lnls-sirius/vacuum-bbb-controller/README.md

# vacuum-bbb-controller
Graphical interface [./software/pydm/pydm_1.2/README.md](./software/pydm/pydm_1.2/README.md)
