lnls-sirius/vacuum-bbb-controller/documentation/readme/pcb_bottom_layer.png

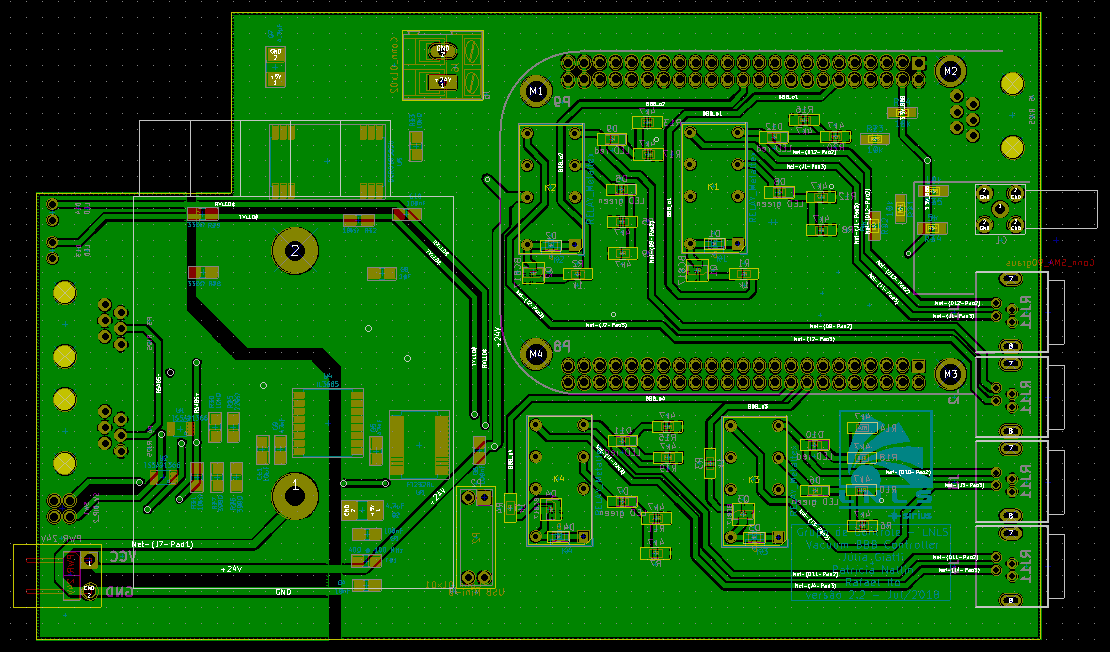
documentation/readme/pcb_bottom_layer.png
