lnls-sirius/vacuum-bbb-controller/documentation/readme/pcb_top_layer.png

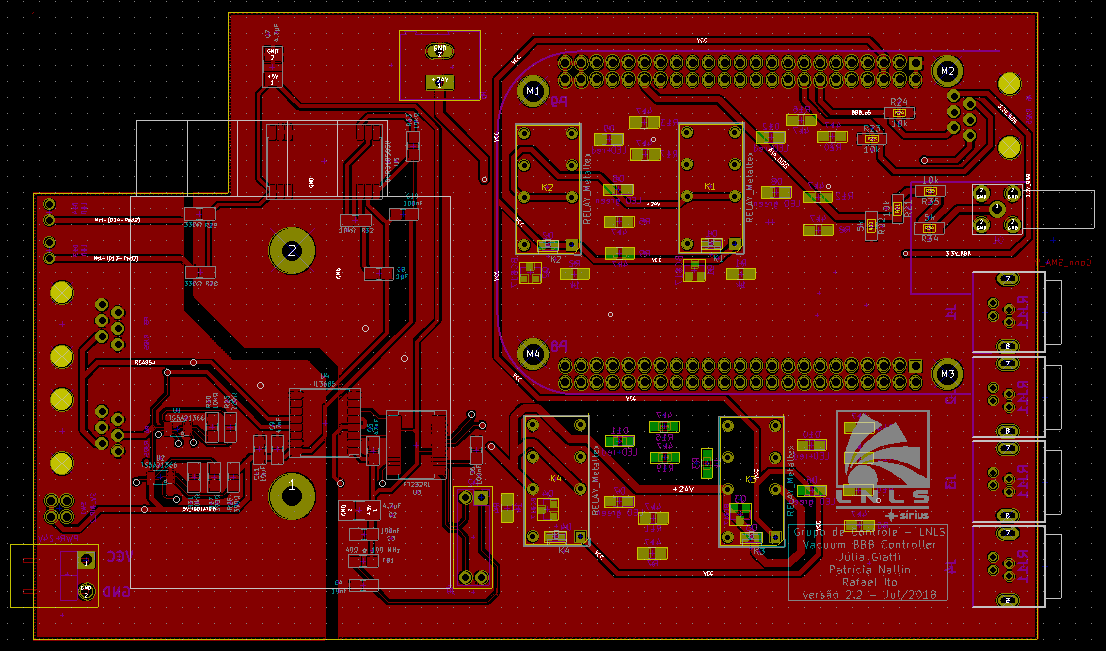
documentation/readme/pcb_top_layer.png
