lnls-sirius/vacuum-bbb-controller/documentation/readme/ui_1_main-window.png

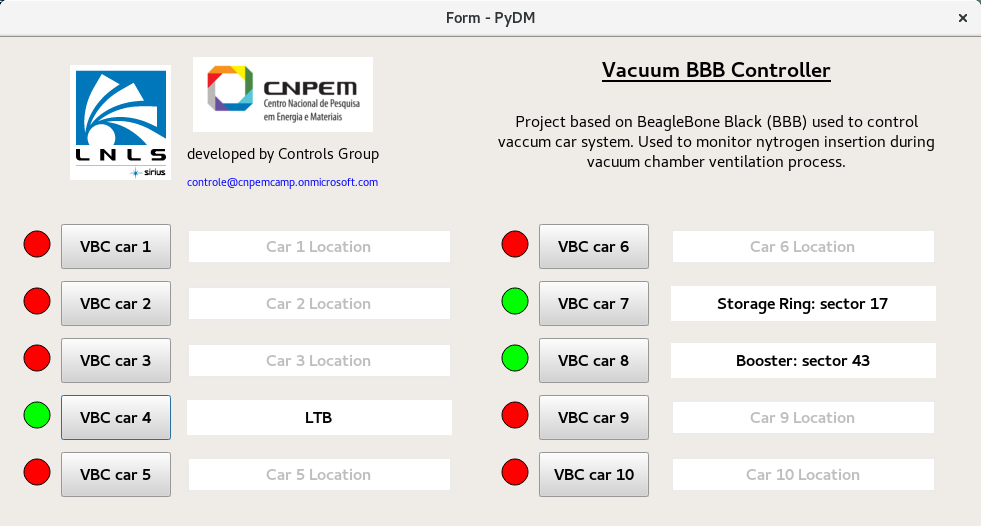
documentation/readme/ui_1_main-window.png
