lnls-sirius/vacuum-bbb-controller/documentation/readme/ui_2_system_window.png

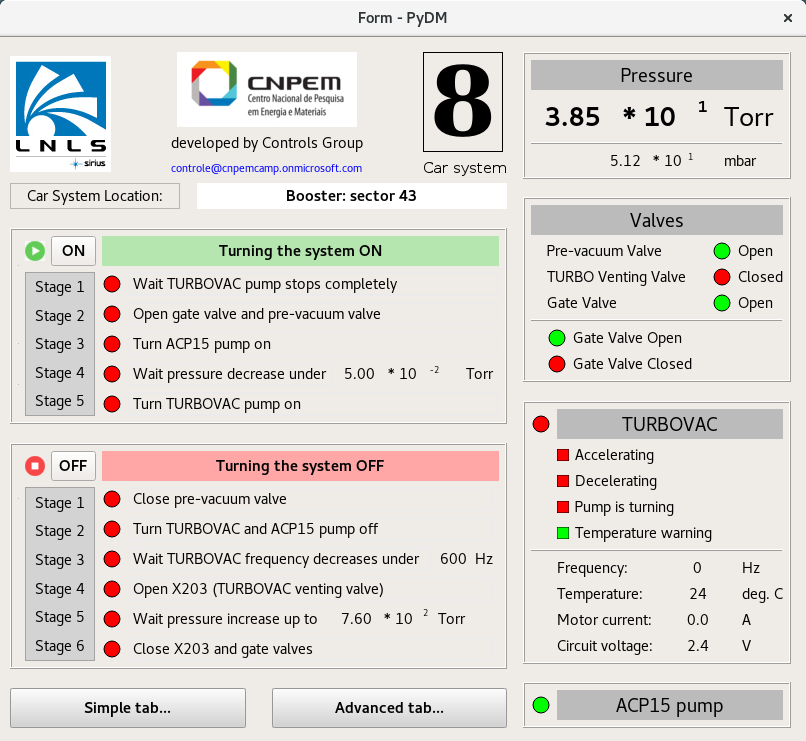
documentation/readme/ui_2_system_window.png
