lnls-sirius/vacuum-bbb-controller/documentation/readme/ui_3_simple_tab.png

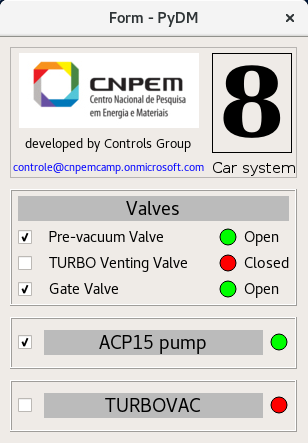
documentation/readme/ui_3_simple_tab.png
