lnls-sirius/vacuum-bbb-controller/documentation/readme/ui_4_advanced_tab_1.png

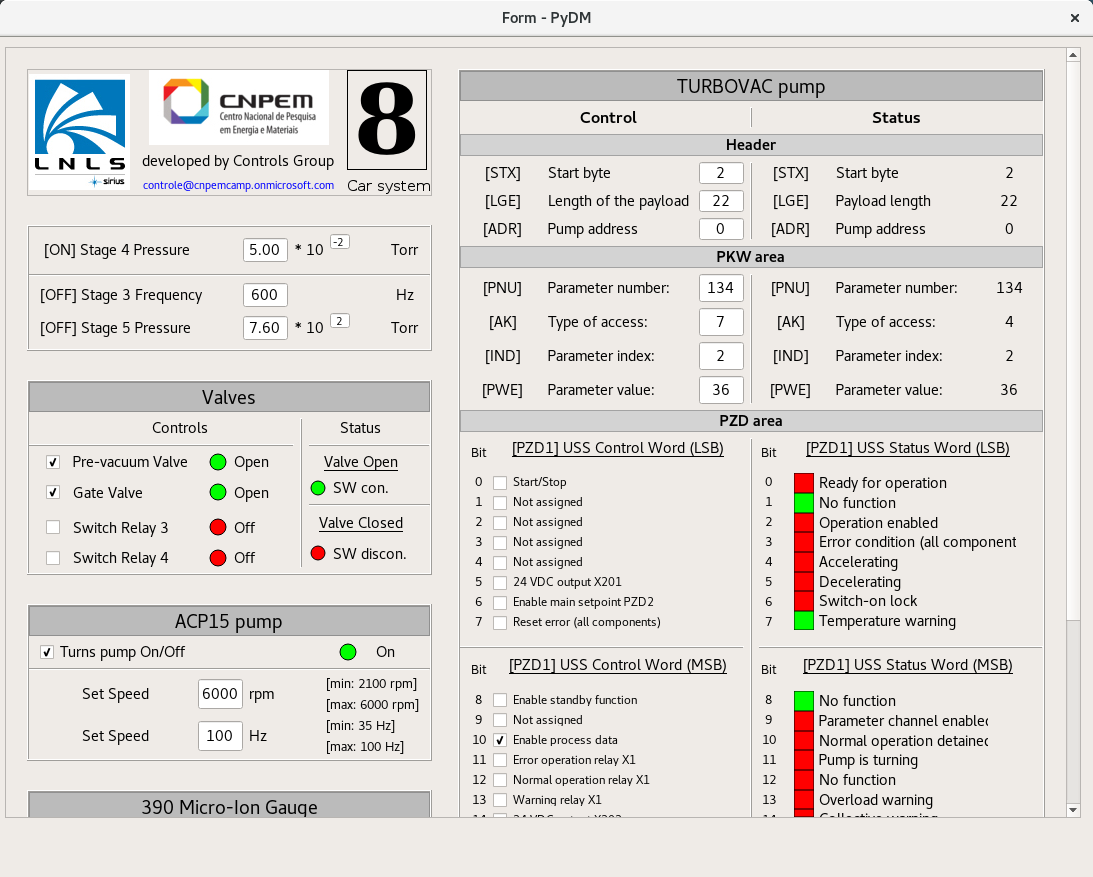
documentation/readme/ui_4_advanced_tab_1.png
