lnls-sirius/vacuum-bbb-controller/documentation/readme/ui_5_advanced_tab_2.png

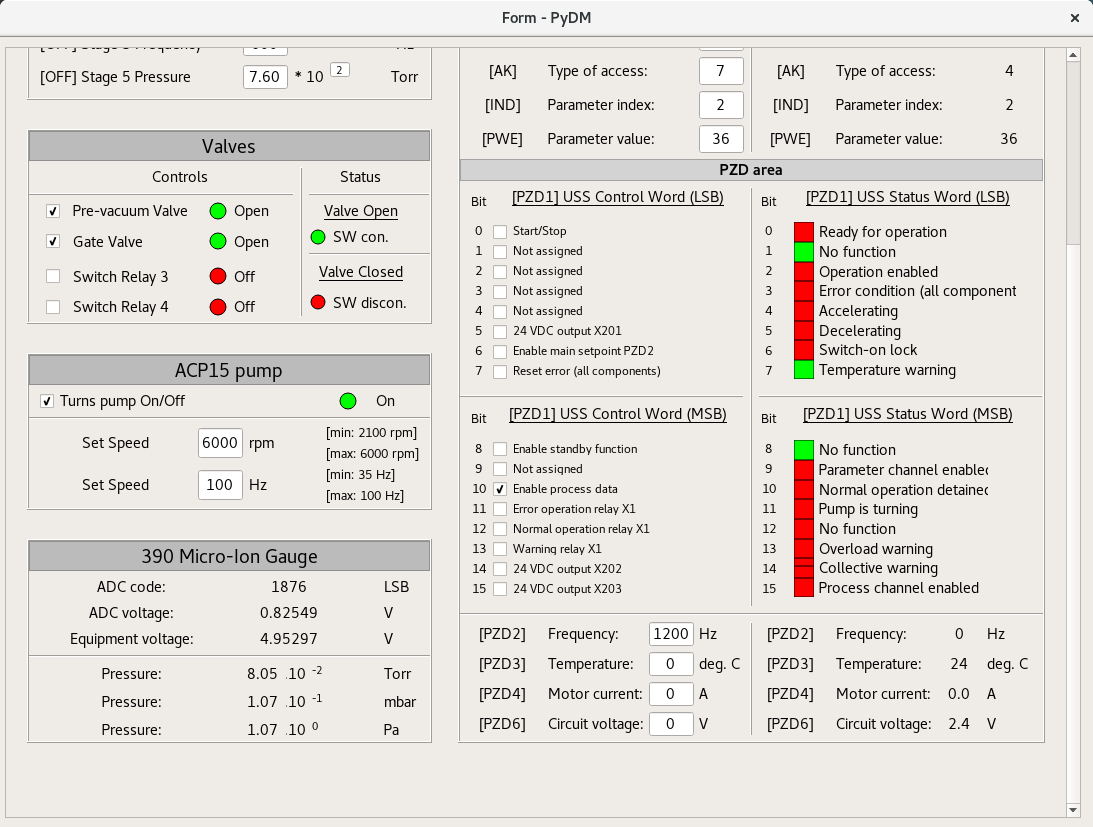
documentation/readme/ui_5_advanced_tab_2.png
