lnls-sirius/vacuum-bbb-controller/hardware/cables/cables.ods

Sheet: Contador
Designator | Description | Value | PartNumber | Package | Manufacturer | Quantity | CNPEM Part Number | OBS | Packaging
Beagle1 | 2x Pin Heander para a BeagleBone Black | BeagleBone | ZW-23-12-F-D-754-178 | 2x Straight_2x23 pitch 2.54mm | SAMTEC | 2 | MT104047 |  | Unit
BR1,BR2 | Bridge Rectifier Single Phase Standard 100V SMD | Diode_Bridge | DF01S-T | RECT_BRIDGE | Diodes Incorporated | 2 | MT107907 |  | Tape
C1 | Aluminum Electrolytic Capacitors Radial SMD 470µF 16V | 470uF | EEE-1CA471UP | CP_Elec_8x5.4 | Panasonic Electronic Components | 1 | AP106777 |  | Tape
C2 | Multilayer Ceramic Capacitors 4.7µF 50V ±10% X7R 1210 SMD | 4.7uF | GRM21BR61E475MA12L | 1210 | Murata | 1 | MT104428 |  | Reel
C27 | Tantalum Capacitor 100uF, 10V, 20%, ESR 0.9ohm | 100uF | TLJT107M010R0900 | 1210 | AVX | 1 | MT103959 |  | Tape
C3,C4 | Ceramic Capacitor SMD ±5% 16V X7R | 1uF | C0805C105J4RACTU | 0805 | AVX | 2 | MT109488 |  | Reel
C30 | Tantalum Capacitor 10uF, 10V, 10%, ESR 3.8ohm | 10uF | 08053C105JAT2A | 1206 | Kemet | 1 | AP111595 |  | Tape
C6 | Ceramic Capacitor 10uF 16V 10% SMD 0805 X5R | 10uF | CL21A106KOQNNNE | 0805 | Samsung ElectroMechanics | 1 | MT104058 |  | Reel
C7,C28,C29 | Multilayer Ceramic Capacitor 100nF 50V 5% SMD 0805 X7R | 100nF | GCM21BR72A104KA37L | 0805 | Murata | 3 | MT114854 |  | Reel
C8,C5,C9,C10 | Ceramic Capacitor 33pF 50V 10% SMD 0805 C0G/NP0 | 33pF | 08055A330JAT2A | 0805 | AVX | 4 | MT112460 |  | Reel
D1 | LED Circuit Board Indicator Single Red Diffused, Through Hole, Right Angle 2V 20mA 90° | LED-Red | WP934CB/ID | 2x1 PTH pitch 2,54mm | Kingbright | 1 | AP110389 |  | Unit
D9,D11 | Diode Schottky 40V 750mA (DC) Surface Mount | Schottky | BAT165E6327HTSA1 | SOD-323 | Infineon Technologies | 2 | MT104048 |  | Tape
D10,D12 | Red LED, 2V, 20mA, SMD 0805 | LED Red | LTST-C171KRKT | 0805 | Lite-On Inc | 2 | AP111653 |  | Reel
J1,J2,J3,J4 | RJ45 Jack Connector Right Angle | RJ45 | SS-60000-010 | RJ45-STEWART | Stewart | 4 | MT107916 |  | Tube
JP1 | DIP Switch SMD 1 position | Dip Switch 1 pos | KAE01SGGT | DIP Switch SMD 1 position | E-Switch | 1 | MT104049 |  | Tube
P1,P2 | Connector 90° PTH 02x08 | CONN_02X08 | 3221-16-0200-00 | 2x08_PTH_Pitch1.27mm | CNC Tech | 2 | MT107378 |  | Unit
Q3,Q2,Q1 | Bipolar (BJT) Transistor NPN SMD 40V 800mA 300MHz 350mW | BSR14 | BSR14 | SOT-23 | Fairchild Semiconductor | 3 | MT104051 |  | Tape
R11,R12 | Resistor SMD 100Ω ±1% 1W Thin Film | 100 | MMB02070C1000FB200 | MELF 0207 | Vishay | 2 | MT112459 |  | Reel
R13,R14 | Resistor SMD 120 Ω ±1% 0.125W Thick Film | 120 | 0805W8F1200T5E | 0805 | RoyalOhm | 2 | MT115760 |  | Reel
R16 | Resistor SMD 620Ω ±1% 0.125W Thick Film | 620 | RK73H2ATTD6200F | 0805 | KOA Speer | 1 | MT109494 |  | Reel
R17 | Resistor SMD 180 ohm 1% 1/8W Thin Film | 180 | 0805W8F1800T5E | 0805 | RoyalOhm | 1 | MT114496 |  | Reel
R18,R5,R6 | Resistor SMD 1K ohm 1% 1/8W Thick Film | 1k | 0805W8F1001T5E | 0805 | RoyalOhm | 3 | MT109492 |  | Reel
R19,R20,R21,R22,R27,R30,R31 | Resistor SMD 10 kΩ ±1% 0.125W Thick Film | 10k | 0805W8F1002T5E | 0805 | RoyalOhm | 7 | MT109485 |  | Reel
R23,R2,R1,R24 | Resistor SMD 0 Ohms 0.125W Thick Film | 0 | RC0805JR-070RL | 0805 | Yageo | 4 | MT100803 | NÃO DEVEM SER MONTADOS | NÃO SERÁ FORNECIDO
R25 | Resistor 910K ohm 1% 1/8W SMD 0805 Thick Film | 910KΩ | 0805W8F9103T5E | 0805 | RoyalOhm | 1 | MT115761 |  | Reel
R26,R29 | Resistor 330 ohm, 1/8W, SMD 0805, Thick Film | 330Ω | 0805W8F3300T5E | 0805 | RoyalOhm | 2 | MT115762 |  | Reel
R28 | Resistor 220K ohm 1% 1/8W SMD 0805 Thick Film | 220kΩ | 0805W8F2203T5E | 0805 | RoyalOhm | 1 | MT115763 |  | Reel
R3,R4 | Resistor SMD 100Ω ±1% 0.125W Thick Film | 100 | RK73H2ATTD1000F | 0805 | KOA Speer | 2 | MT115765 |  | Reel
R7,R8,R9,R10, R15 | Resistor SMD 4.7 kΩ ±1% 0.125W Thick Film | 4k7 | 0805W8F4701T5E | 0805 | RoyalOhm | 4 | MT115764 |  | Reel
T1 | Module XFRMR LAN 10/100 PoE SMD | Module-XFRMR-POE | S558-5500-25-F | Module-XFRMR-Poe | Bel Fuse Inc. | 1 | MT107908 |  | Tape
T2,T3 | 2 Line Common Mode Choke Surface Mount 500 Ohm @ 100MHz 4A DCR 27 mOhm | Transformer_1P_1S | DLW5BTM501SQ2L | Horizontal, 6 PC Pad | Murata | 2 | MT109675 |  | Tape
U1,U2,U3,U4,U5,U6,U23,U24 | Single D-type Flip-flop | 741G74 | 296-25554-2-ND | TSSOP-8 | Texas Instruments | 8 | AP105702 |  | Tape
U14,U15,U20 | 2 Circuit IC Switch 1:1 1Ω US8 | TS5A21366 | TS5A21366DCUR | VSSOP-8 | Texas Instruments | 3 | AP109801 |  | Tape
U16 | Isolated PoE module Output 5V – 13W | Ag9200 | AG9205S | 9200-Silvertel | Silvertel | 1 | MT107905 |  | Unit
U17 | Isolated Module DC DC Converter 5V→5V 200mA 1W | VIBLSD1-S5-S5-DIP | VIBLSD1-S5-S5-DIP | 14-DIP-5 Leads | CUI Inc. | 1 | MT108027 |  | Tube
U18 | Isolated Module DC DC Converter 5V→±12V 42mA 1W | MEV1D0512DC | MEV1D0512DC | 14-DIP-6 Leads | Murata Power Solutions Inc. | 1 | MT108008 |  | Tube
U19,U22 | IC Single 2-input AND Gate SMD SOT-353 | 1G08 | 74AHC1G08SE-7 | SOT-353 | Diodes Inc | 2 | MT104245 |  | Reel
U21 | IC 74HC123 SMD SOIC-16 | 74HC123 | 74HC123D | SOIC-16 | NXP Semiconductors | 1 | AP111593 |  | Tape
U7,U12,U13 | Buffer Inverting 1 channel SMD | 1G04 | 74AHC1G04SE-7 | SOT-353 | Diodes Inc | 3 | MT104246 |  | Reel
U8,U9,U10,U11,U25,U26 | Buffer Non-Inverting Push-Pull Output | 1G125 | 74AHC1G125SE-7 | SOT-353 | Nexperia Inc | 6 | MT103958 |  | Reel

Sheet: Montagem mecânica
Designator | Description | Value | PartNumber | Package | Manufacturer | Quantity | CNPEM Part Number | OBS | Packaging
Beagle1 | 2x Pin Heander para a BeagleBone Black | BeagleBone | ZW-23-12-F-D-754-178 | 2x Straight_2x23 pitch 2.54mm | SAMTEC | 2 | MT104047 |  | Unit | 312
BR1,BR2 | Bridge Rectifier Single Phase Standard 100V SMD | Diode_Bridge | DF01S-T | RECT_BRIDGE | Diodes Incorporated | 2 | MT107907 |  | Tape | 392
C1 | Aluminum Electrolytic Capacitors Radial SMD 470µF 16V | 470uF | EEE-1CA471UP | CP_Elec_8x5.4 | Panasonic Electronic Components | 1 | AP106777 |  | Tape | 200
C2 | Multilayer Ceramic Capacitors 4.7µF 50V ±10% X7R 1210 SMD | 4.7uF | GRM21BR61E475MA12L | 1210 | Murata | 1 | MT104428 |  | Reel | 500
C27 | Tantalum Capacitor 100uF, 10V, 20%, ESR 0.9ohm | 100uF | TLJT107M010R0900 | 1210 | AVX | 1 | MT103959 |  | Tape | 250
C3,C4 | Ceramic Capacitor SMD ±5% 16V X7R | 1uF | C0805C105J4RACTU | 0805 | AVX | 2 | MT109488 |  | Reel | 1500
C30 | Tantalum Capacitor 10uF, 10V, 10%, ESR 3.8ohm | 10uF | 08053C105JAT2A | 1206 | Kemet | 1 | AP111595 |  | Tape | 250
C6 | Ceramic Capacitor 10uF 16V 10% SMD 0805 X5R | 10uF | CL21A106KOQNNNE | 0805 | Samsung ElectroMechanics | 1 | MT104058 |  | Reel | 423
C7,C28,C29 | Multilayer Ceramic Capacitor 100nF 50V 5% SMD 0805 X7R | 100nF | GCM21BR72A104KA37L | 0805 | Murata | 3 | MT114854 |  | Reel | 3000
C8,C5,C9,C10 | Ceramic Capacitor 33pF 50V 10% SMD 0805 C0G/NP0 | 33pF | 08055A330JAT2A | 0805 | AVX | 4 | MT112460 |  | Reel | 3500
D1 | LED Circuit Board Indicator Single Red Diffused, Through Hole, Right Angle 2V 20mA 90° | LED-Red | WP934CB/ID | 2x1 PTH pitch 2,54mm | Kingbright | 1 | AP110389 |  | Unit | 175
D9,D11 | Diode Schottky 40V 750mA (DC) Surface Mount | Schottky | BAT165E6327HTSA1 | SOD-323 | Infineon Technologies | 2 | MT104048 |  | Tape | 500
D10,D12 | Red LED, 2V, 20mA, SMD 0805 | LED Red | LTST-C171KRKT | 0805 | Lite-On Inc | 2 | AP111653 |  | Reel | 3000
J1,J2,J3,J4 | RJ45 Jack Connector Right Angle | RJ45 | SS-60000-010 | RJ45-STEWART | Stewart | 4 | MT107916 |  | Tube | 600
JP1 | DIP Switch SMD 1 position | Dip Switch 1 pos | KAE01SGGT | DIP Switch SMD 1 position | E-Switch | 1 | MT104049 |  | Tube | 175
P1,P2 | Connector 90° PTH 02x08 | CONN_02X08 | 3221-16-0200-00 | 2x08_PTH_Pitch1.27mm | CNC Tech | 2 | MT107378 |  | Unit | 300
Q3,Q2,Q1 | Bipolar (BJT) Transistor NPN SMD 40V 800mA 300MHz 350mW | BSR14 | BSR14 | SOT-23 | Fairchild Semiconductor | 3 | MT104051 |  | Tape | 550
R11,R12 | Resistor SMD 100Ω ±1% 1W Thin Film | 100 | MMB02070C1000FB200 | MELF 0207 | Vishay | 2 | MT112459 |  | Reel | 2000
R13,R14 | Resistor SMD 120 Ω ±1% 0.125W Thick Film | 120 | 0805W8F1200T5E | 0805 | RoyalOhm | 2 | MT115760 |  | Reel | 4800
R16 | Resistor SMD 620Ω ±1% 0.125W Thick Film | 620 | RK73H2ATTD6200F | 0805 | KOA Speer | 1 | MT109494 |  | Reel | 4504
R17 | Resistor SMD 180 ohm 1% 1/8W Thin Film | 180 | 0805W8F1800T5E | 0805 | RoyalOhm | 1 | MT114496 |  | Reel | 4500
R18,R5,R6 | Resistor SMD 1K ohm 1% 1/8W Thick Film | 1k | 0805W8F1001T5E | 0805 | RoyalOhm | 3 | MT109492 |  | Reel | 4073
R19,R20,R21,R22,R27,R30,R31 | Resistor SMD 10 kΩ ±1% 0.125W Thick Film | 10k | 0805W8F1002T5E | 0805 | RoyalOhm | 7 | MT109485 |  | Reel | 3500
R23,R2,R1,R24 | Resistor SMD 0 Ohms 0.125W Thick Film | 0 | RC0805JR-070RL | 0805 | Yageo | 4 | MT100803 | NÃO DEVEM SER MONTADOS | NÃO SERÁ FORNECIDO | NÃO SERÁ FORNECIDO
R25 | Resistor 910K ohm 1% 1/8W SMD 0805 Thick Film | 910KΩ | 0805W8F9103T5E | 0805 | RoyalOhm | 1 | MT115761 |  | Reel | 5000
R26,R29 | Resistor 330 ohm, 1/8W, SMD 0805, Thick Film | 330Ω | 0805W8F3300T5E | 0805 | RoyalOhm | 2 | MT115762 |  | Reel | 5000
R28 | Resistor 220K ohm 1% 1/8W SMD 0805 Thick Film | 220kΩ | 0805W8F2203T5E | 0805 | RoyalOhm | 1 | MT115763 |  | Reel | 5000
R3,R4 | Resistor SMD 100Ω ±1% 0.125W Thick Film | 100 | RK73H2ATTD1000F | 0805 | KOA Speer | 2 | MT115765 |  | Reel | 4000
R7,R8,R9,R10, R15 | Resistor SMD 4.7 kΩ ±1% 0.125W Thick Film | 4k7 | 0805W8F4701T5E | 0805 | RoyalOhm | 4 | MT115764 |  | Reel | 5000
T1 | Module XFRMR LAN 10/100 PoE SMD | Module-XFRMR-POE | S558-5500-25-F | Module-XFRMR-Poe | Bel Fuse Inc. | 1 | MT107908 |  | Tape | 195
T2,T3 | 2 Line Common Mode Choke Surface Mount 500 Ohm @ 100MHz 4A DCR 27 mOhm | Transformer_1P_1S | DLW5BTM501SQ2L | Horizontal, 6 PC Pad | Murata | 2 | MT109675 |  | Tape | 388
U1,U2,U3,U4,U5,U6,U23,U24 | Single D-type Flip-flop | 741G74 | 296-25554-2-ND | TSSOP-8 | Texas Instruments | 8 | AP105702 |  | Tape | 1500
U14,U15,U20 | 2 Circuit IC Switch 1:1 1Ω US8 | TS5A21366 | TS5A21366DCUR | VSSOP-8 | Texas Instruments | 3 | AP109801 |  | Tape | 568
U16 | Isolated PoE module Output 5V – 13W | Ag9200 | AG9205S | 9200-Silvertel | Silvertel | 1 | MT107905 |  | Unit | 152
U17 | Isolated Module DC DC Converter 5V→5V 200mA 1W | VIBLSD1-S5-S5-DIP | VIBLSD1-S5-S5-DIP | 14-DIP-5 Leads | CUI Inc. | 1 | MT108027 |  | Tube | 175
U18 | Isolated Module DC DC Converter 5V→±12V 42mA 1W | MEV1D0512DC | MEV1D0512DC | 14-DIP-6 Leads | Murata Power Solutions Inc. | 1 | MT108008 |  | Tube | 150
U19,U22 | IC Single 2-input AND Gate SMD SOT-353 | 1G08 | 74AHC1G08SE-7 | SOT-353 | Diodes Inc | 2 | MT104245 |  | Reel | 3000
U21 | IC 74HC123 SMD SOIC-16 | 74HC123 | 74HC123D | SOIC-16 | NXP Semiconductors | 1 | AP111593 |  | Tape | 200
U7,U12,U13 | Buffer Inverting 1 channel SMD | 1G04 | 74AHC1G04SE-7 | SOT-353 | Diodes Inc | 3 | MT104246 |  | Reel | 3000
U8,U9,U10,U11,U25,U26 | Buffer Non-Inverting Push-Pull Output | 1G125 | 74AHC1G125SE-7 | SOT-353 | Nexperia Inc | 6 | MT103958 |  | Reel | 3000
 | Cbo modular macho-macho 8P8C (RJ45,ETHERNET) |  | DK-1511-001/BL |  | Assmann WSW Components | 1 | MT107917 |  | Unit | 150
 | CAIXA DE ALUMINIO 159.99MM X 130.00MM X 53.00MM, TAMANHO EUROCARD |  | 1455N1601 |  |  |  | AP110391 |  | Unit | 150

Sheet: Sheet3
CABO | TAMANHO
Gate control (4P4C) | 2,15 m
Gate read (6P6C) | 2,15 m
Turbo (6P6C) | 1,5 m
ACP15 (6P6C) | 1,3 m
Leitura analógica – cabo coaxial | 2,05 m
Válvula entre Turbo e ACP15 (4P4C) | 1,70 m
