lnls-sirius/vacuum-bbb-controller/hardware/mechanical parts/electronics enclosure/front panel/Painel-frontal_VBC.dxf

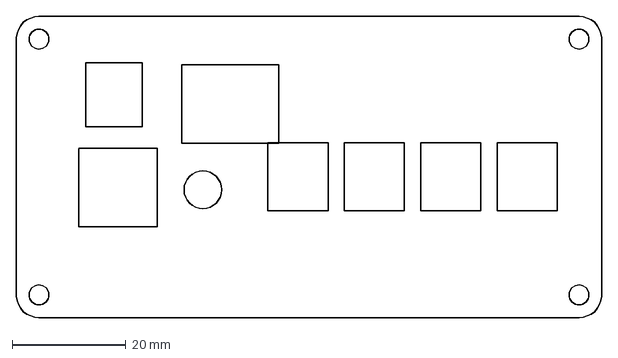
[picture p8: CAD file, 2018-07-27]
hardware/mechanical parts/electronics enclosure/front panel/Painel-frontal_VBC.dxf
103.0 x 53.0 mm
