lnls-sirius/vacuum-bbb-controller/hardware/mechanical parts/electronics enclosure/rear panel/Painel-traseiro_VBC.dxf

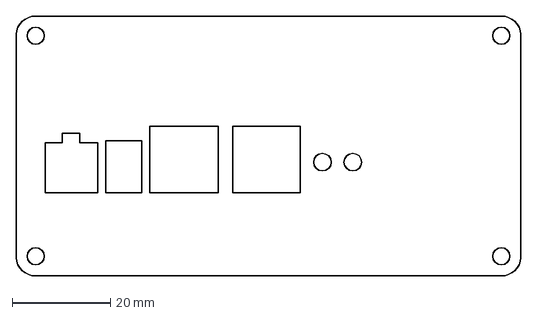
[picture p9: CAD file, 2018-07-27]
hardware/mechanical parts/electronics enclosure/rear panel/Painel-traseiro_VBC.dxf
103.0 x 53.0 mm
