lnls-sirius/vacuum-bbb-controller/hardware/mechanical parts/power supply enclosure/front panel/painel_v1-0.dxf

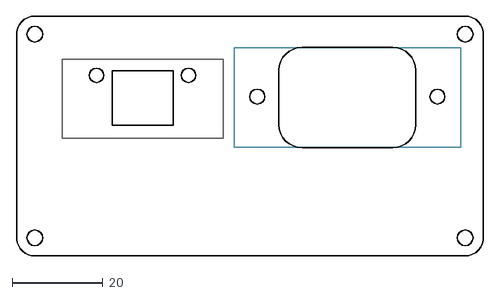
[picture p10: CAD file, 2018-08-20]
hardware/mechanical parts/power supply enclosure/front panel/painel_v1-0.dxf
103.2 x 53.0
