lnls-sirius/vacuum-bbb-controller/(list of files, cad)

Other CAD files:
hardware/mechanical parts/power supply enclosure/support for power supply/placa-fixacao_oficina.dwg
hardware/mechanical parts/power supply enclosure/support for power supply/placa-fixacao_v2-0.dwg
hardware/mechanical parts/electronics enclosure/front panel/Painel-frontal_VBC.dwg
hardware/mechanical parts/electronics enclosure/rear panel/Painel-traseiro_VBC.dwg
hardware/mechanical parts/power supply enclosure/front panel/painel_v1-0.dwg
