lnls-sirius/vacuum-bbb-controller/documentation/datasheets and manuals/Others/Venting Valve.jpg

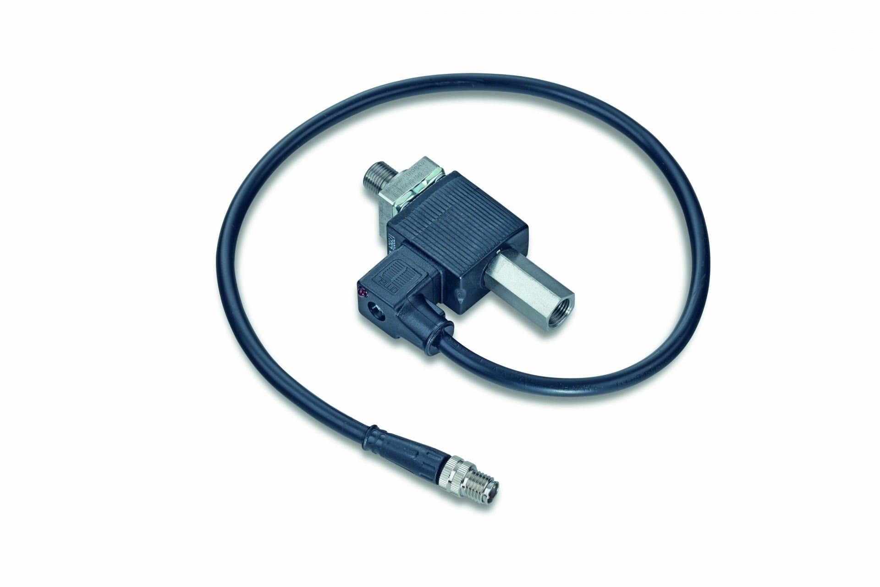
documentation/datasheets and manuals/Others/Venting Valve.jpg
