lnls-sirius/vacuum-bbb-controller/documentation/datasheets and manuals/TURBOVAC/Turbomolecular DC IN (X10) M8 connector.png

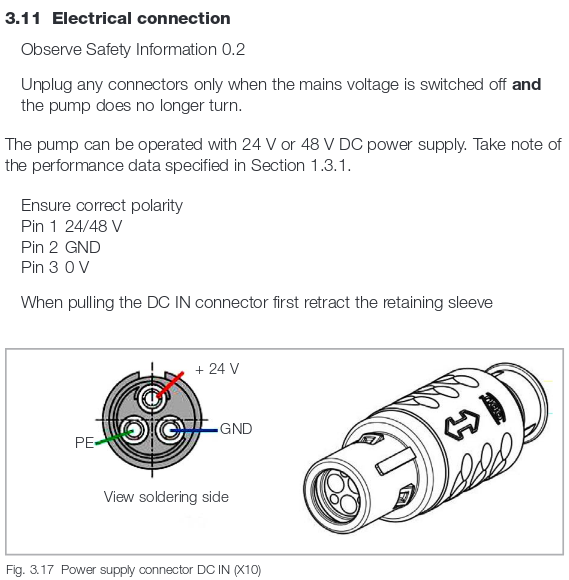
documentation/datasheets and manuals/TURBOVAC/Turbomolecular DC IN (X10) M8 connector.png
