lnls-sirius/vacuum-bbb-controller/documentation/datasheets and manuals/TURBOVAC/TURBOVAC accessory connection (X201, X202, X203).png

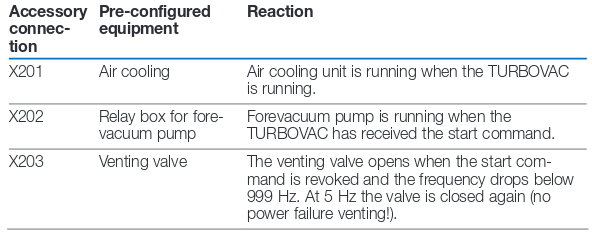
documentation/datasheets and manuals/TURBOVAC/TURBOVAC accessory connection (X201, X202, X203).png
