lnls-sirius/vacuum-bbb-controller/documentation/datasheets and manuals/TURBOVAC/TURBOVAC i(X) informations.png

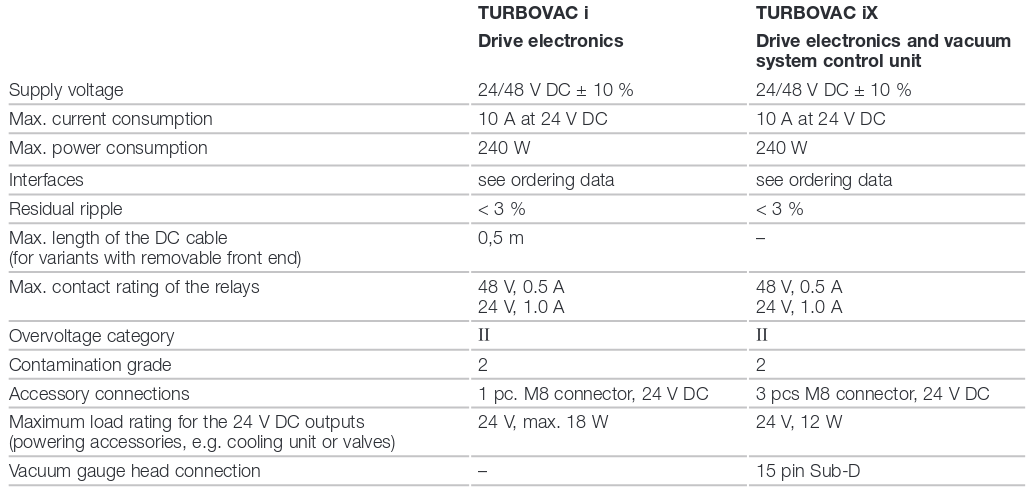
documentation/datasheets and manuals/TURBOVAC/TURBOVAC i(X) informations.png
