lnls-sirius/vacuum-bbb-controller/hardware/cables/TURBOVAC cable/TURBOVAC cable.pdf

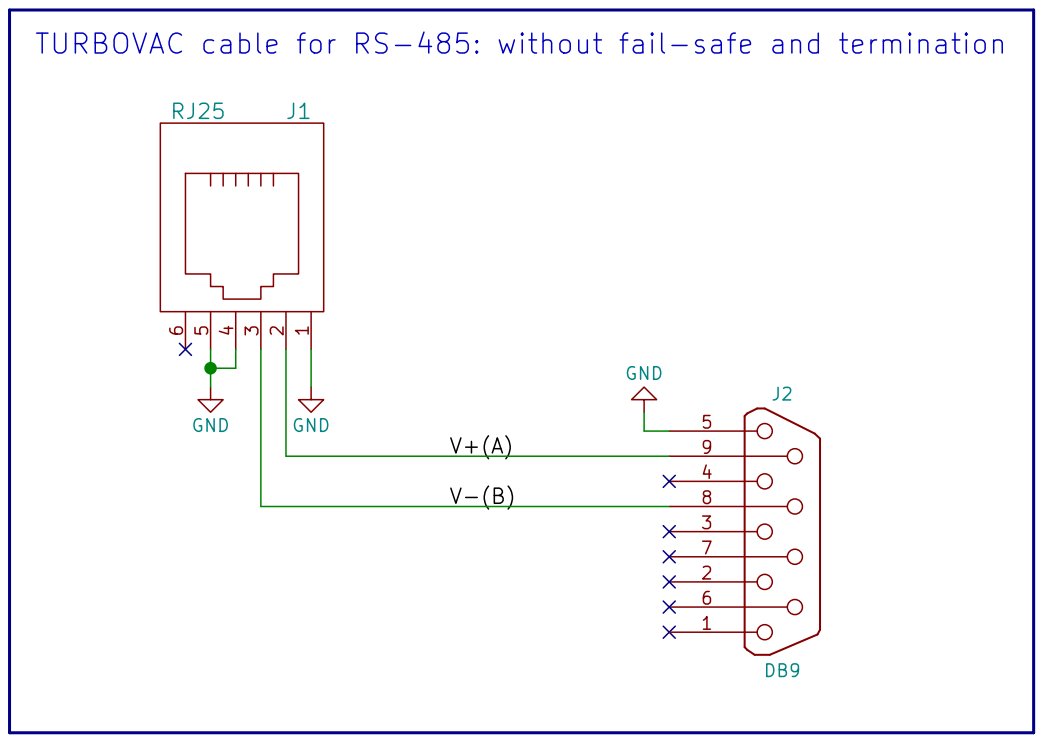
[picture p15: page 1]

TURBOVAC cable for RS-485: without fail-safe and termination

Id: 1/1 Title: File: TURBOVAC cable.sch Sheet: /
