lnls-sirius/vacuum-bbb-controller/hardware/cables/ACP cable/ACP cable.pdf

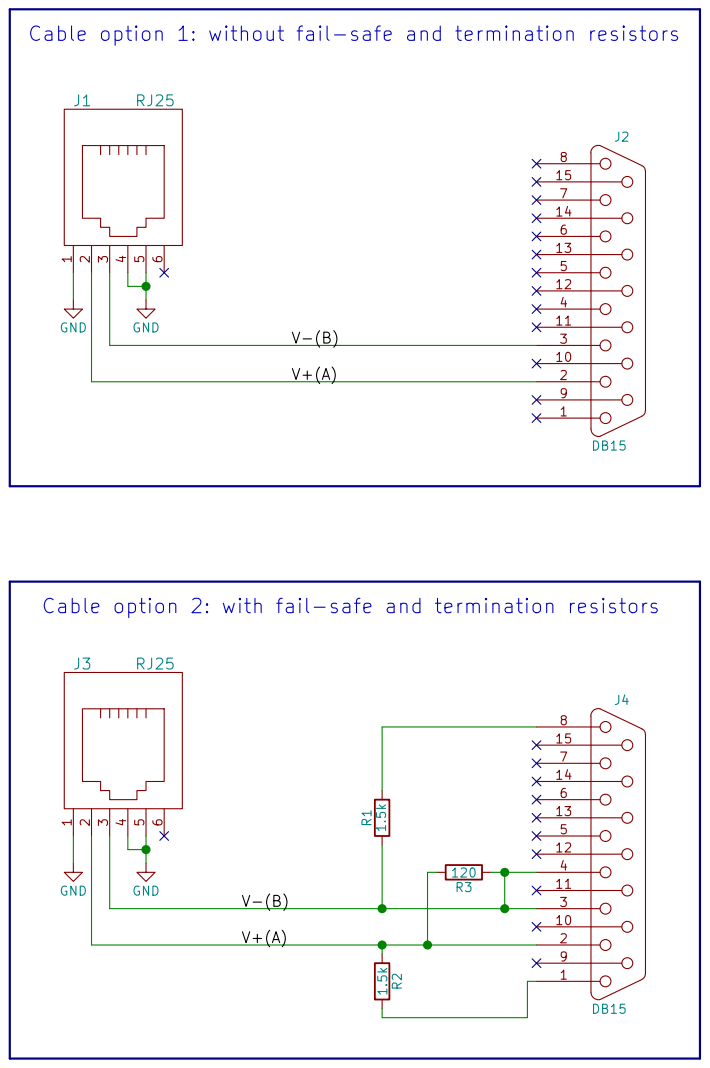
[picture p16: page 1]

120 Cable option 1: without fail-safe and termination resistors

Cable option 2: with fail-safe and termination resistors

Id: 1/1 Title: File: ACP cable.sch Sheet: /
