lnls-sirius/vacuum-bbb-controller/hardware/kicad/VBC v2.2/VBC_v2-2.pdf

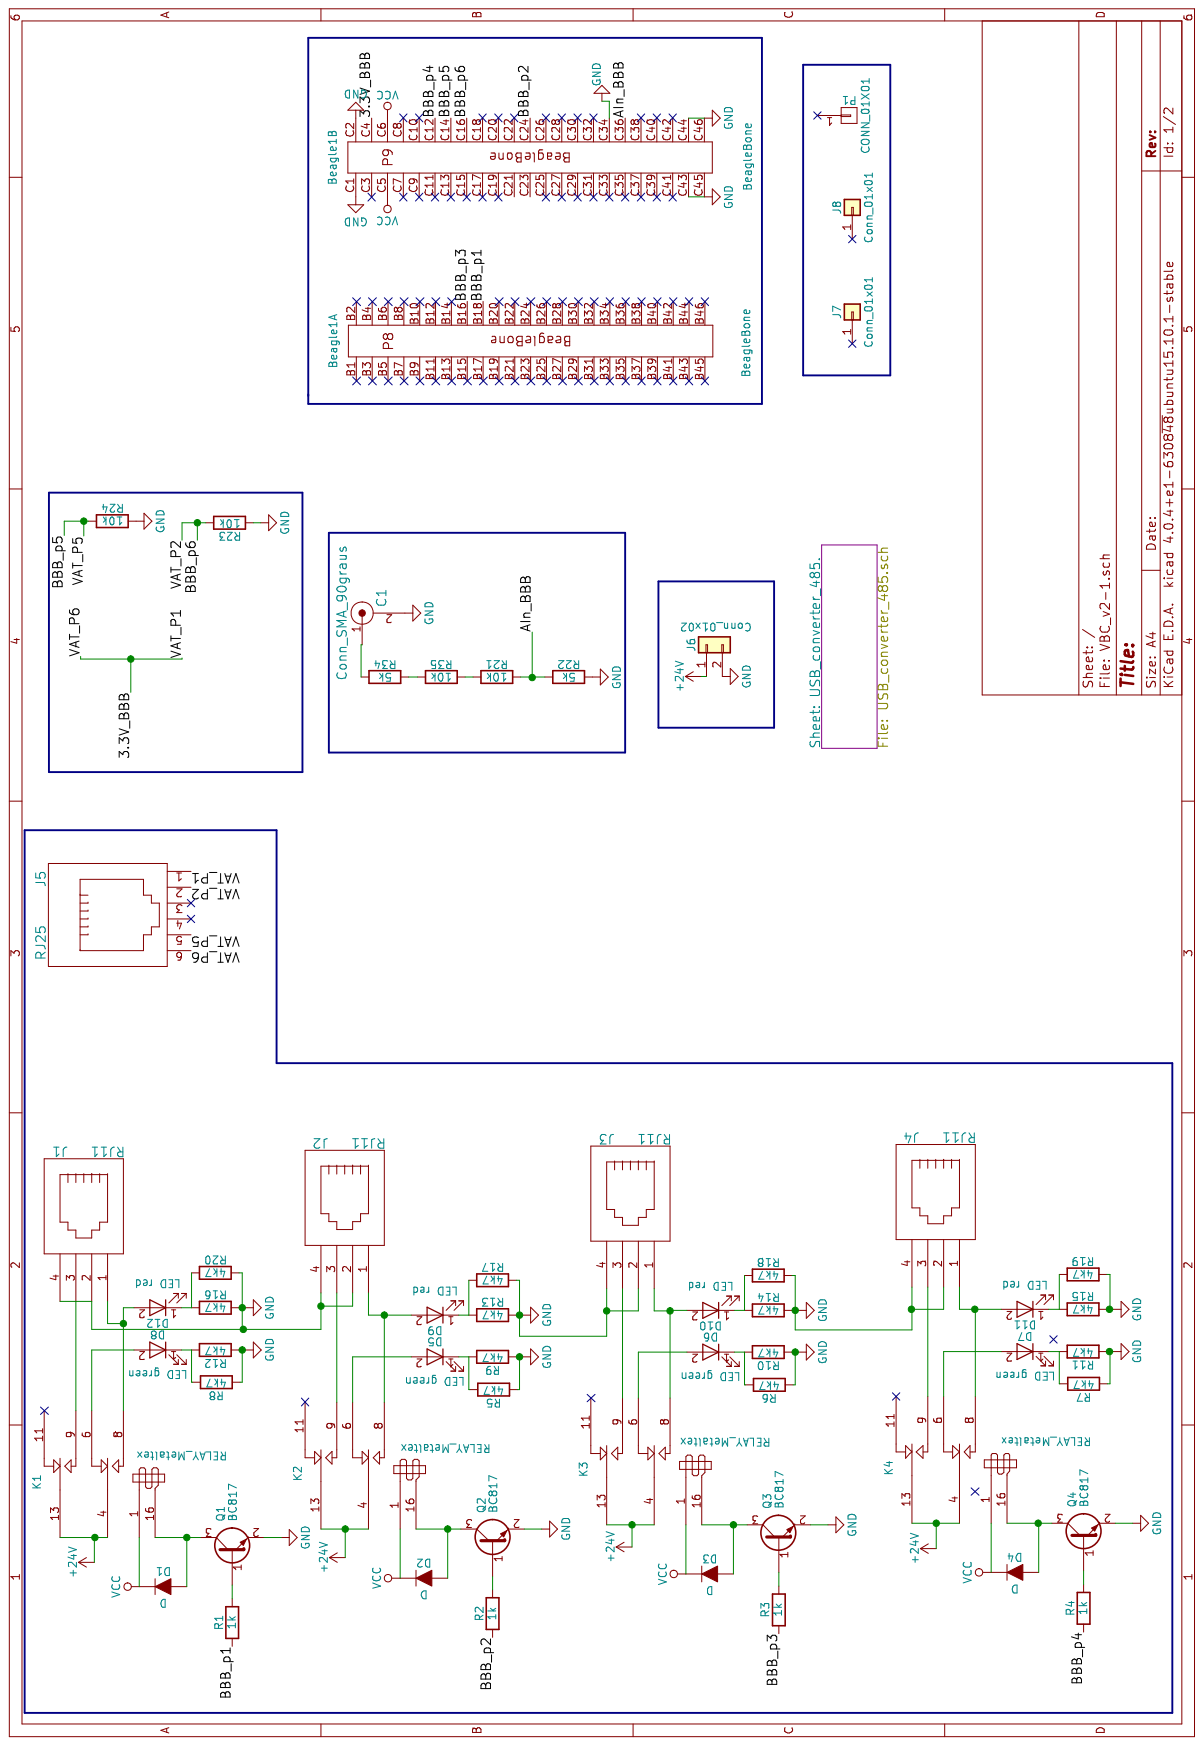
[picture p17: page 1]

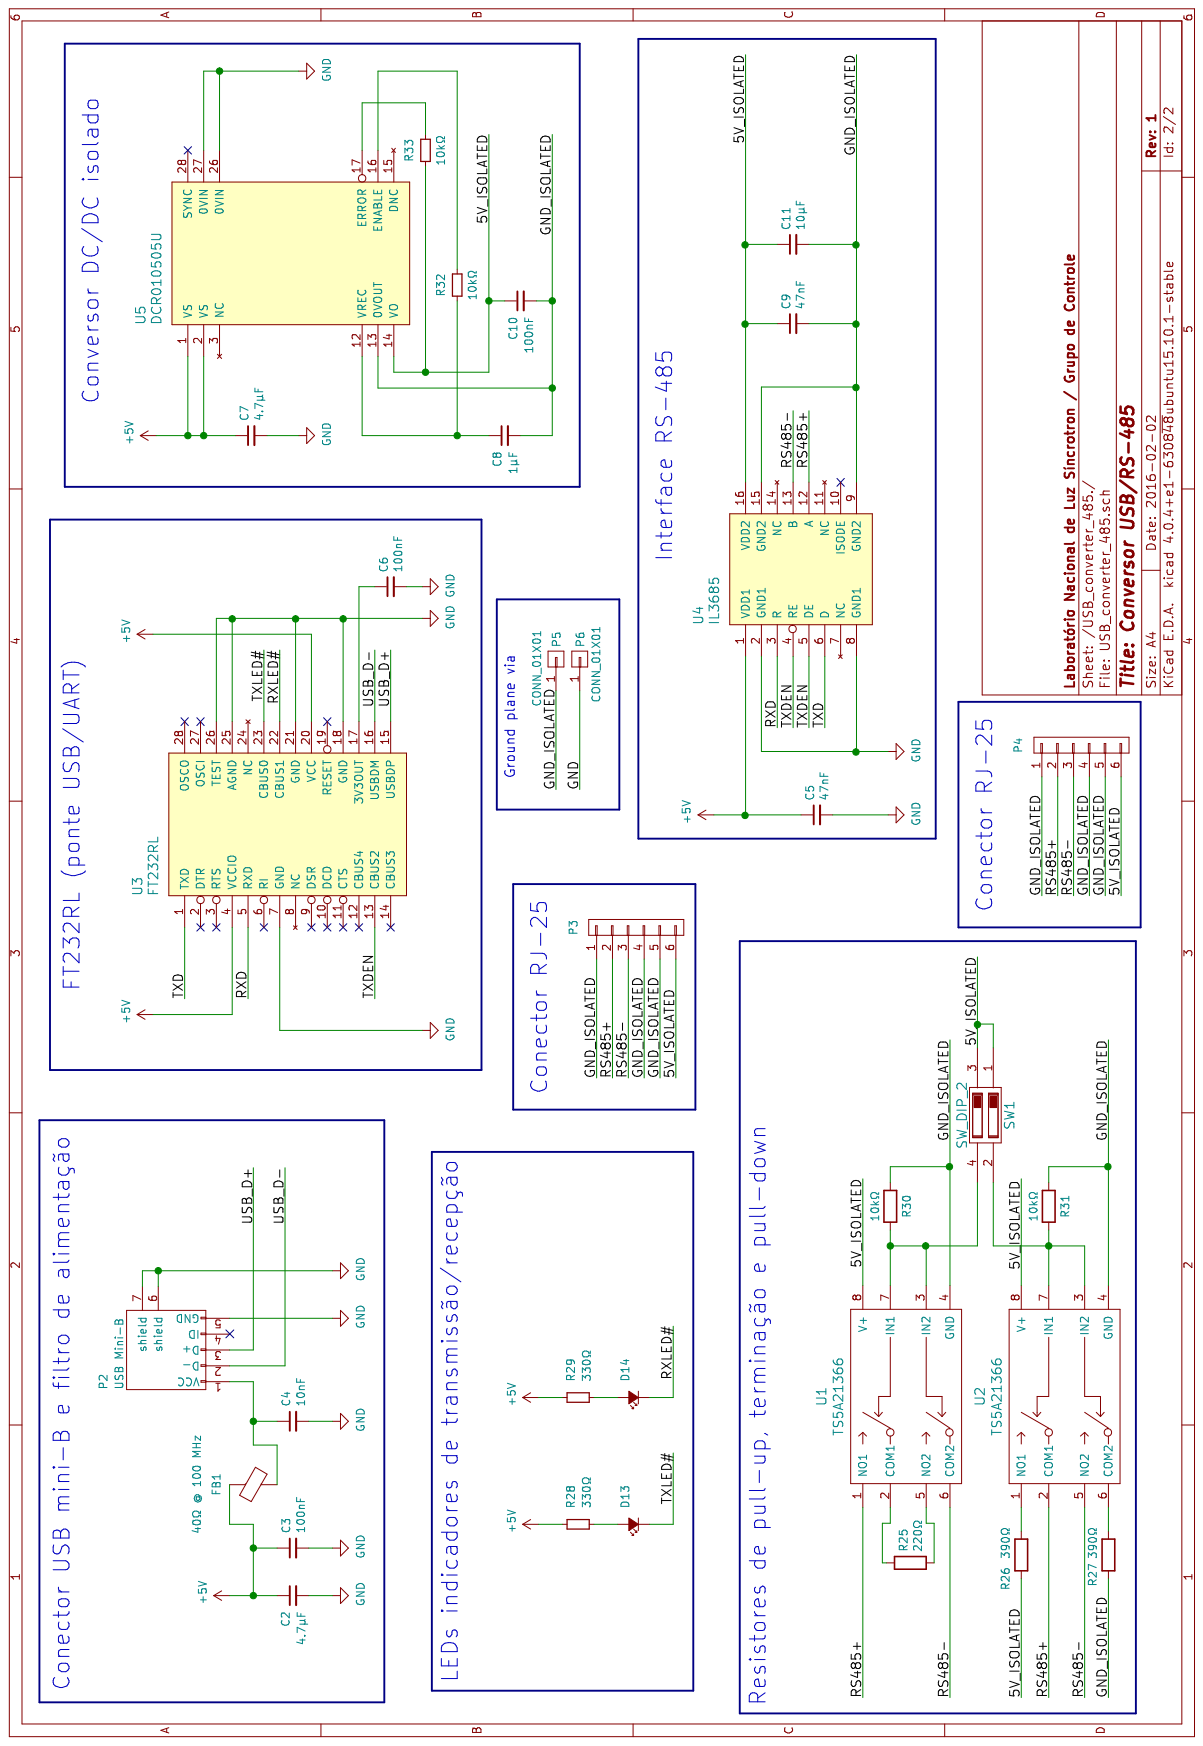
[picture p18: page 2]
