lnls-sirius/vacuum-bbb-controller/hardware/kicad/VBC v1.0/VBC.pdf

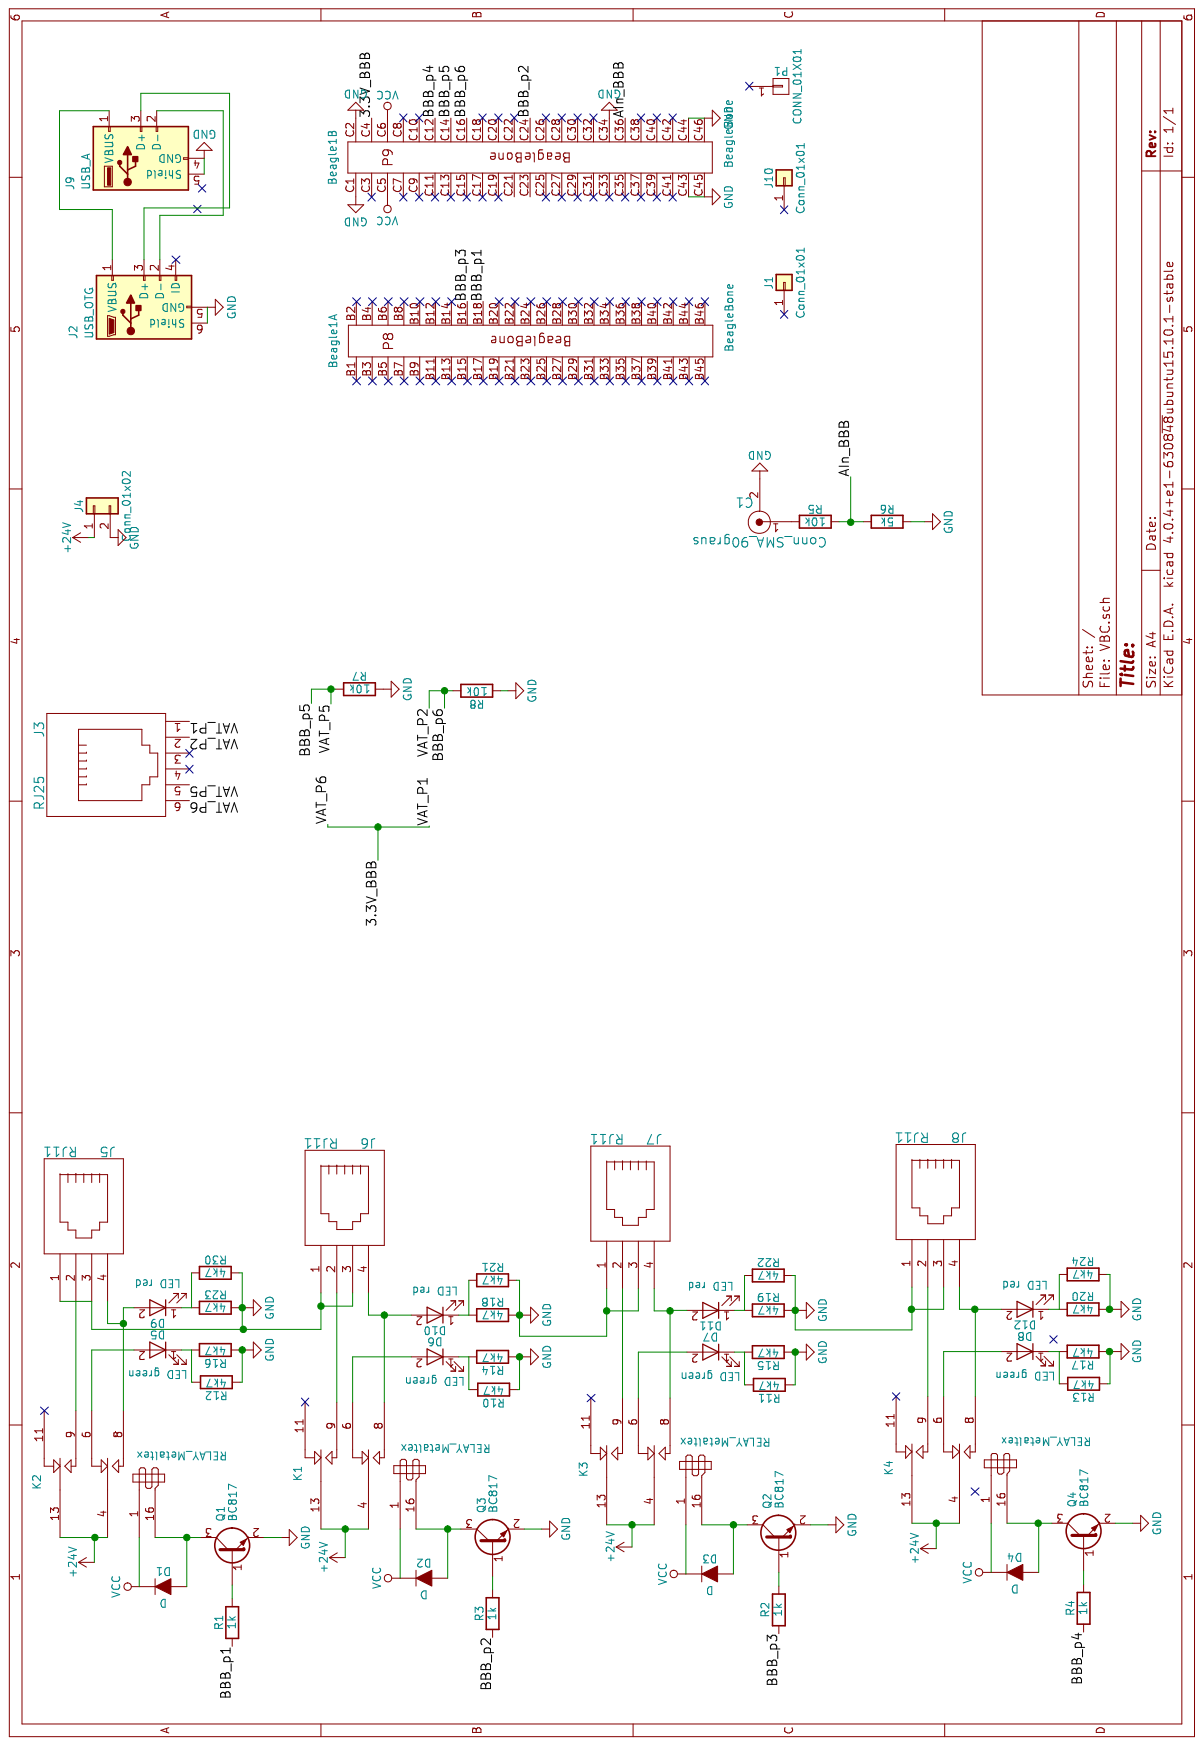
[picture p19: page 1]
