lnls-sirius/vacuum-bbb-controller/hardware/kicad/VBC v2.1/VBC_v2-1.kicad_pcb

## KiCad design hardware/kicad/VBC v2.1/VBC_v2-1.kicad_pcb (2018-11-26, an earlier design)

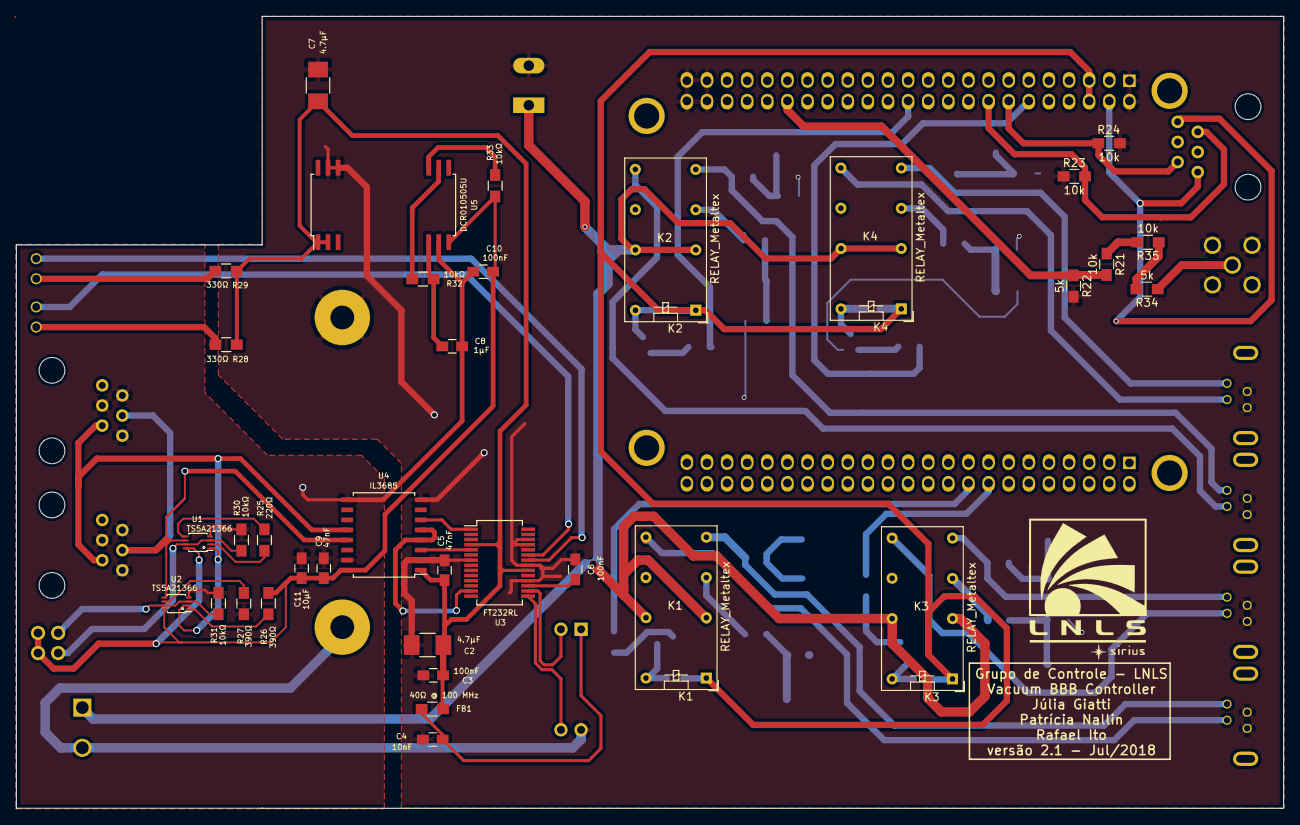
[picture p20: board VBC_v2-1.kicad_pcb from above]

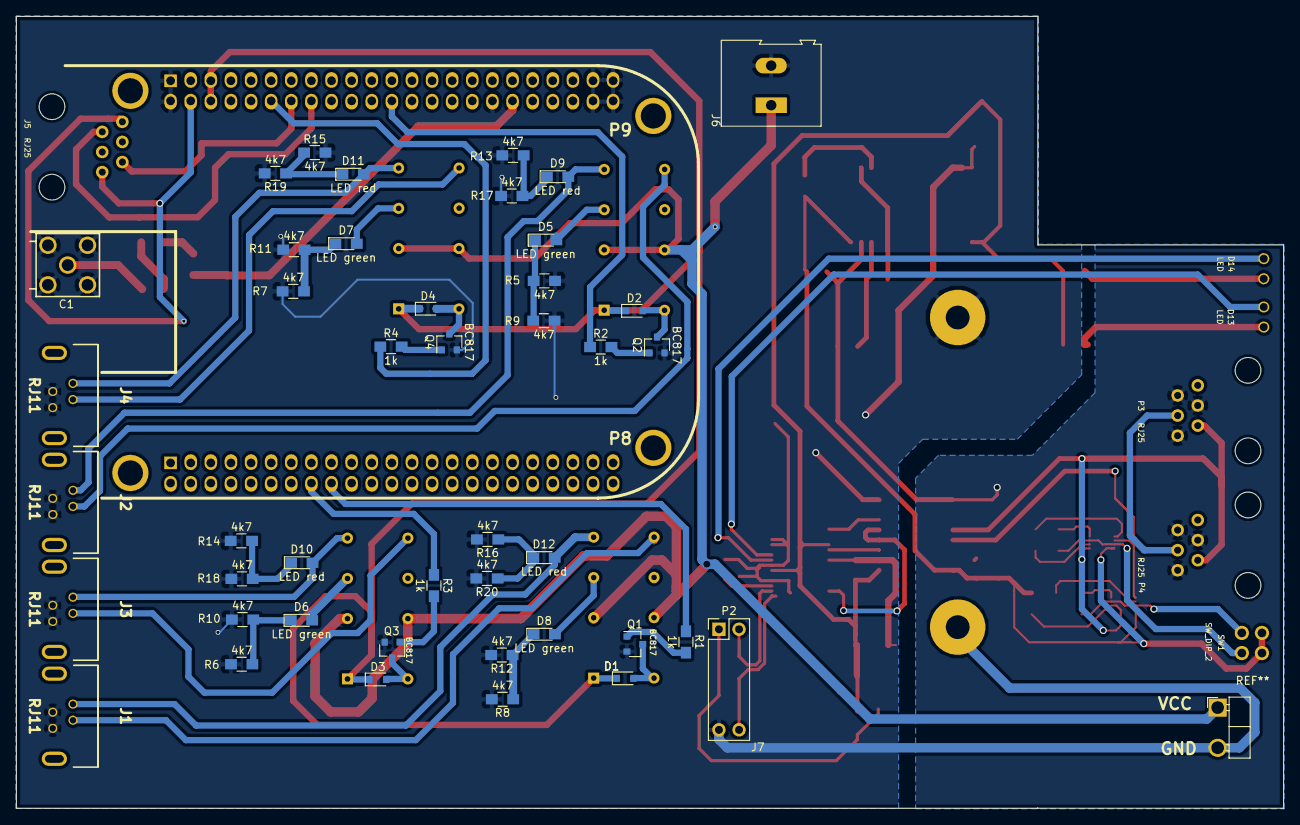
[picture p21: board VBC_v2-1.kicad_pcb from below]

Board: 2 copper layers, 160.0 x 100.1 mm, 85 parts (50 on the bottom side), 63 nets.

Parts:
C1: SMA_Molex_73251-2201
C2, C7: 4.7µF; C_1210_HandSoldering
C3, C6, C10: 100nF; C_0805_HandSoldering
C4: 10nF; C_0805_HandSoldering
C5, C9: 47nF; C_0805_HandSoldering
C8: 1µF; C_0805_HandSoldering
C11: 10µF; C_0805_HandSoldering
D1, D2, D3, D4: D; D_0805
D5, D6, D7, D8: LED green; LED_0805_HandSoldering
D9, D10, D11, D12: LED red; LED_0805_HandSoldering
D13, D14: LED; LED_para_painel_KINGBRIGHT
FB1: 40Ω @ 100 MHz; R_0805_HandSoldering
J1, J2, J3, J4: RJ11; RJ11-4P4C-HIROSE_2
J5: RJ25; RJ25_(conversor)
J6: TerminalBlock_Altech_AK300-2_P5.00mm
J7: Conn_01x01; Mean_Well_RS15
K1, K2, K3, K4: RELAY_Metaltex; Relay_DPDT_Omron_G5V-2
P2: USB Mini-B; Pin_Header_Straight_2x06_Pitch2.54mm
P3, P4: RJ25
Q1, Q2, Q3, Q4: BC817; SOT-23
R1, R2, R3, R4: 1k; R_0805_HandSoldering
R5, R6, R7, R8, R9, R10, R11, R12, R13, R14, R15, R16, R17, R18, R19, R20: 4k7; R_0805_HandSoldering
R21, R23, R24, R35: 10k; R_0805_HandSoldering
R22, R34: 5k; R_0805_HandSoldering
R25: 220Ω; R_0805_HandSoldering
R26, R27: 390Ω; R_0805_HandSoldering
R28, R29: 330Ω; R_0805_HandSoldering
R30, R31, R32, R33: 10kΩ; R_0805_HandSoldering
SW1: SW_DIP_2; DIP_switch_(2_positions)
U1, U2: TS5A21366; VSSOP-8
U3: FT232RL; SSOP-28_5.3x10.2mm_Pitch0.65mm
U4: IL3685; SOIC-16_7.5x10.3mm_Pitch1.27mm
U5: DCR010505U

Connections:
+5V: C2.1, C3.1, C5.1, C7.1, FB1.1, R28.1, R29.1, U3.4, U3.20, U4.1, U5.1, U5.2
+24V: J6.1, K1.4, K1.13, K2.4, K2.13, K3.4, K3.13, K4.4, K4.13
/3.3V_BBB: J5.1, J5.6
/AIn_BBB: R21.2, R22.1
/BBB_p5: J5.5, R24.1
/BBB_p6: J5.2, R23.2
/USB_converter_485./5V_ISOLATED: C9.1, C10.1, C11.1, R26.2, R33.1, SW1.1, SW1.3, U1.8, U2.8, U4.16, U5.14
/USB_converter_485./GND_ISOLATED: C8.2, C9.2, C10.2, C11.2, P3.1, P3.4, P3.5, P4.1, P4.4, P4.5, R27.2, R30.1, R31.1, U1.4, U2.4, U4.9, U4.15, U5.13
/USB_converter_485./RS485+: P3.2, P4.2, U1.1, U2.2, U4.12
/USB_converter_485./RS485-: P3.3, P4.3, U1.6, U2.5, U4.13
/USB_converter_485./RXD: U3.5, U4.3
/USB_converter_485./RXLED#: D14.1, U3.22
/USB_converter_485./TXD: U3.1, U4.6
/USB_converter_485./TXDEN: U3.13, U4.4, U4.5
/USB_converter_485./TXLED#: D13.1, U3.23
/USB_converter_485./USB_D+: P2.3, U3.15
/USB_converter_485./USB_D-: P2.2, U3.16
GND: C1.2, C2.2, C3.2, C4.2, C5.2, C6.2, C7.2, J1.2, J1.4, J2.2, J2.4, J3.2, J3.4, J4.2, J4.4, J6.2, J7.1, J7.2, P2.5, Q1.2, Q2.2, Q3.2, Q4.2, R5.2, R6.2, R7.2, R8.2, R9.2, R10.2, R11.2, R12.2, R13.2, R14.2, R15.2, R16.2, R17.2, R18.2, R19.2, R20.2, R22.2, R23.1, R24.2, U3.7, U3.18, U3.21, U3.25, U3.26, U4.2, U4.8, U5.26, U5.27
unnamed: C1.1, R34.1
unnamed: C4.1, FB1.2, P2.1
unnamed: C6.1, U3.17
unnamed: C8.1, R32.1, U5.12
unnamed: D1.2, K1.16, Q1.3
unnamed: D2.2, K2.16, Q2.3
unnamed: D3.2, K3.16, Q3.3
unnamed: D4.2, K4.16, Q4.3
unnamed: D5.1, R5.1, R9.1
unnamed: D5.2, K2.6
unnamed: D6.1, R6.1, R10.1
unnamed: D6.2, K3.6
unnamed: D7.1, R7.1, R11.1
unnamed: D7.2, K4.6
unnamed: D8.1, R8.1, R12.1
unnamed: D8.2, K1.6
unnamed: D9.1, R13.1, R17.1
unnamed: D9.2, J2.1, K2.8
unnamed: D10.1, R14.1, R18.1
unnamed: D10.2, J3.1, K3.8
unnamed: D11.1, R15.1, R19.1
unnamed: D11.2, J4.1, K4.8
unnamed: D12.1, R16.1, R20.1
unnamed: D12.2, J1.1, K1.8
unnamed: D13.2, R28.2
unnamed: D14.2, R29.2
unnamed: J1.3, K1.9
unnamed: J2.3, K2.9
unnamed: J3.3, K3.9
unnamed: J4.3, K4.9
unnamed: Q1.1, R1.2
unnamed: Q2.1, R2.2
unnamed: Q3.1, R3.2
unnamed: Q4.1, R4.2
unnamed: R21.1, R35.2
unnamed: R25.1, U1.2
unnamed: R25.2, U1.5
unnamed: R26.1, U2.1
unnamed: R27.1, U2.6
unnamed: R30.2, SW1.4, U1.3, U1.7
unnamed: R31.2, SW1.2, U2.3, U2.7
unnamed: R32.2, U5.16
unnamed: R33.2, U5.17
unnamed: R34.2, R35.1
VCC: D1.1, D2.1, D3.1, D4.1, K1.1, K2.1, K3.1, K4.1
