lnls-sirius/vacuum-bbb-controller/hardware/kicad/VBC v1.0/VBC.kicad_pcb

## KiCad design hardware/kicad/VBC v1.0/VBC.kicad_pcb (2018-07-18, an earlier design)

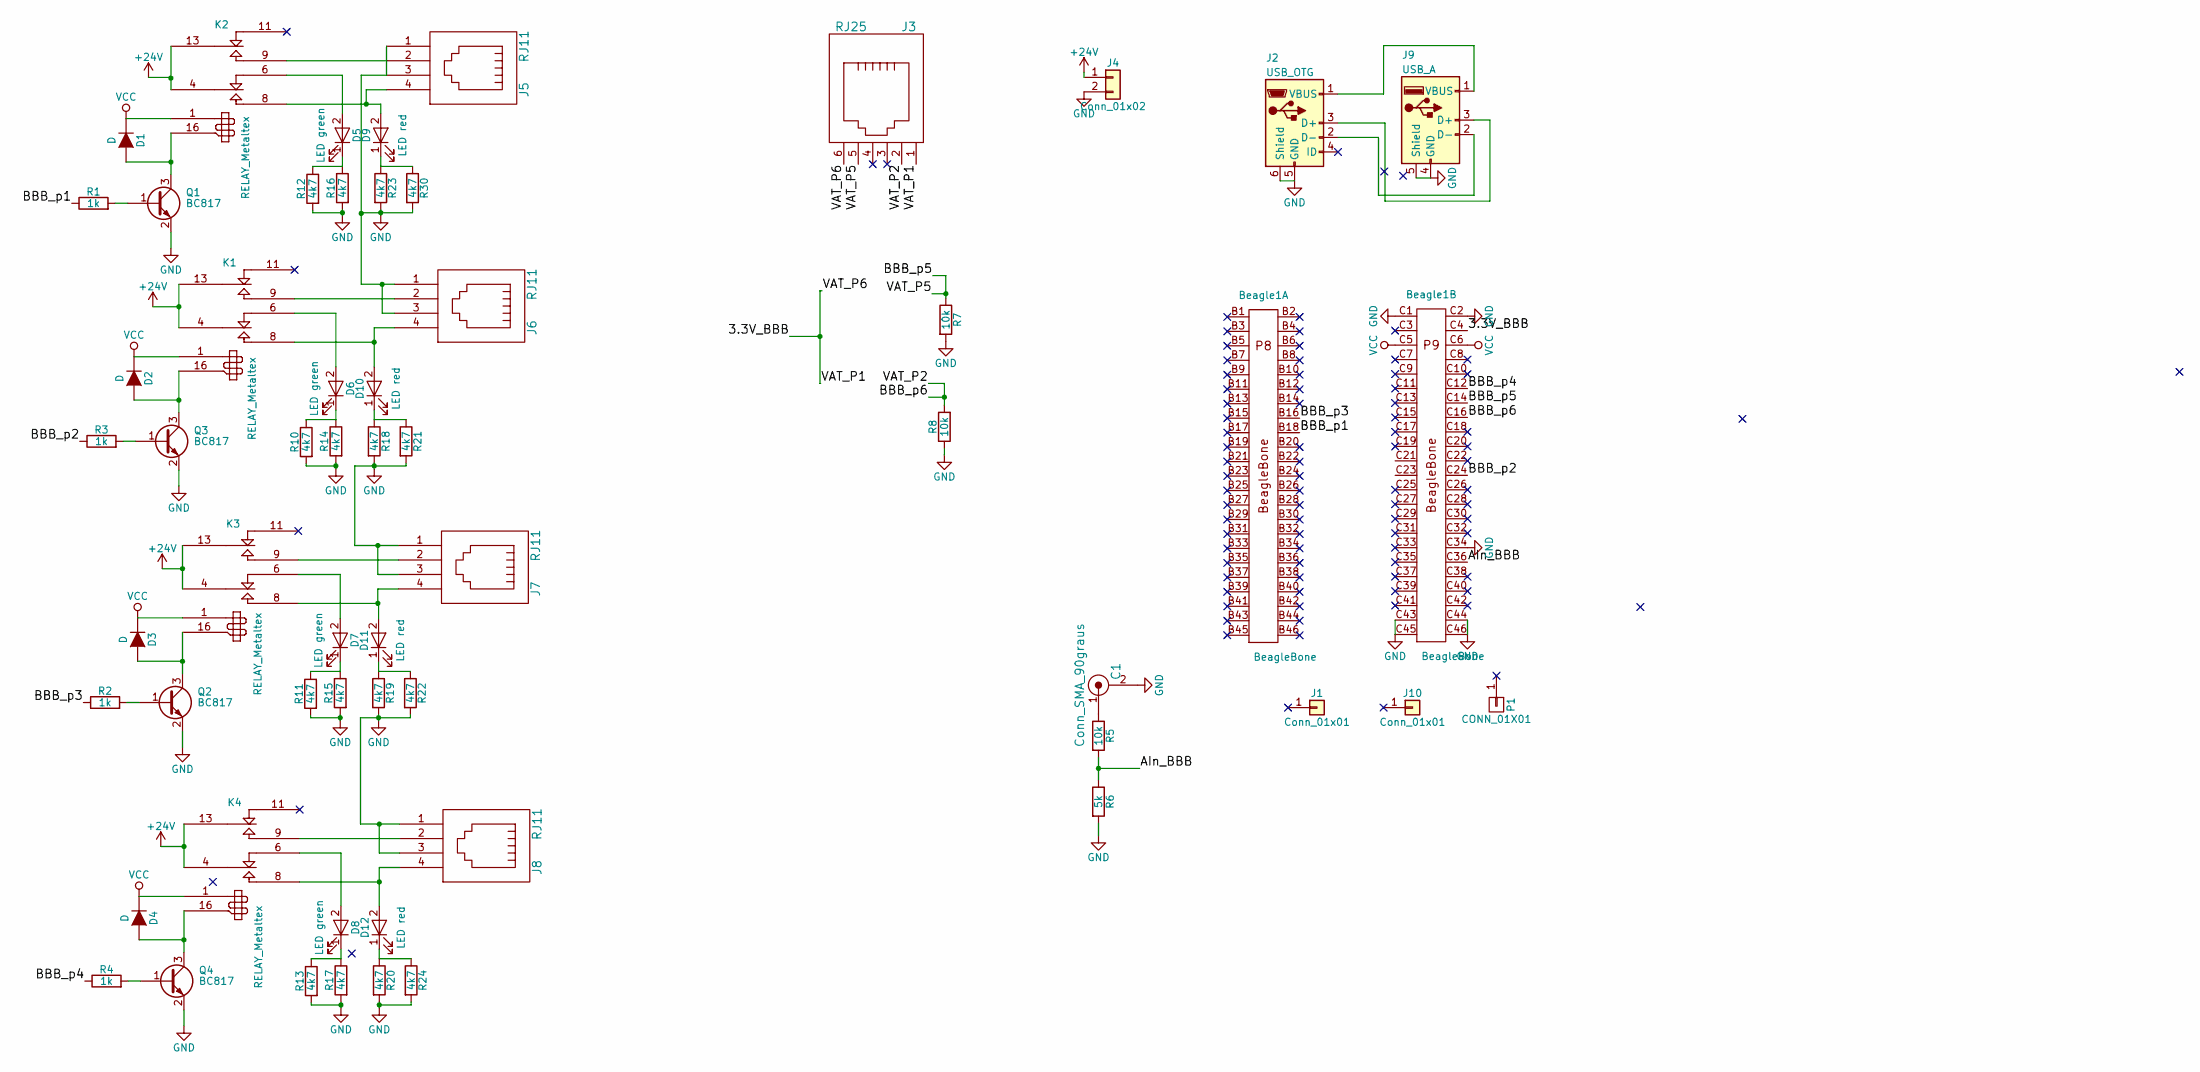
[picture p22: schematic VBC.sch]

Parts:
Beagle1: BeagleBone; BEAGLEBONEBLACK
C1: Conn_SMA_90graus; SMA_THT_Jack_Straight
D1, D2, D3, D4: D; D_0805
D5, D6, D7, D8: LED green; LED_0805_HandSoldering
D9, D10, D11, D12: LED red; LED_0805_HandSoldering
J1: Conn_01x01; Mean_Well_RS15
J2: USB_OTG; USB_Micro-B
J3: RJ25; RJ25_(conversor)
J4: Conn_01x02; TerminalBlock_Altech_AK300-2_P5.00mm
J5, J6, J7, J8: RJ11; RJ11-4P4C-HIROSE
J9: USB_A
J10: Conn_01x01; BEAGLEBONEBLACK_(fixation_holes)
K1, K2, K3, K4: RELAY_Metaltex; Relay_DPDT_Omron_G5V-2
P1: CONN_01X01; LNLS_LOGO
Q1, Q2, Q3: BC817; SOT-23
Q4: BC817; R_0805_HandSoldering
R1, R2, R3, R4: 1k; R_0805_HandSoldering
R5, R7, R8: 10k; R_0805_HandSoldering
R6: 5k; R_0805_HandSoldering
R10, R11, R12, R13, R14, R15, R16, R17, R18, R19, R20, R21, R22, R23, R24: 4k7; R_0805_HandSoldering
R30: 4k7; R_0805

Connections:
+24V: J4.1, K1.4 (C1), K1.13 (C2), K2.4 (C1), K2.13 (C2), K3.4 (C1), K3.13 (C2), K4.4 (C1), K4.13 (C2)
/3.3V_BBB: Beagle1.C4, J3.1, J3.6
/AIn_BBB: Beagle1.C36, R5.2, R6.1
/BBB_p1: Beagle1.B18, R1.1
/BBB_p2: Beagle1.C24, R3.1
/BBB_p3: Beagle1.B16, R2.1
/BBB_p4: Beagle1.C12 (B12), R4.1
/BBB_p5: Beagle1.C14, J3.5, R7.1
/BBB_p6: Beagle1.C16, J3.2, R8.2
GND: Beagle1.C1, Beagle1.C2, Beagle1.C34, Beagle1.C43, Beagle1.C44, Beagle1.C45, Beagle1.C46, C1.2, J2.5 (GND), J2.6 (Shield), J4.2, J5.1, J5.3, J6.1, J6.3, J7.1, J7.3, J8.1, J8.3, J9.4 (GND), J9.5 (Shield), Q1.2 (E), Q2.2 (E), Q3.2 (E), Q4.2 (E), R6.2, R7.2, R8.1, R10.2, R11.2, R12.2, R13.2, R14.2, R15.2, R16.2, R17.2, R18.2, R19.2, R20.2, R21.2, R22.2, R23.2, R24.2, R30.2
unnamed: C1.1, R5.1
unnamed: D1.2 (A), K2.16, Q1.3 (C)
unnamed: D2.2 (A), K1.16, Q3.3 (C)
unnamed: D3.2 (A), K3.16, Q2.3 (C)
unnamed: D4.2 (A), K4.16, Q4.3 (C)
unnamed: D5.1 (K), R12.1, R16.1
unnamed: D5.2 (A), K2.6 (R1)
unnamed: D6.1 (K), R10.1, R14.1
unnamed: D6.2 (A), K1.6 (R1)
unnamed: D7.1 (K), R11.1, R15.1
unnamed: D7.2 (A), K3.6 (R1)
unnamed: D8.1 (K), R13.1, R17.1
unnamed: D8.2 (A), K4.6 (R1)
unnamed: D9.1 (K), R23.1, R30.1
unnamed: D9.2 (A), J5.4, K2.8 (T1)
unnamed: D10.1 (K), R18.1, R21.1
unnamed: D10.2 (A), J6.4, K1.8 (T1)
unnamed: D11.1 (K), R19.1, R22.1
unnamed: D11.2 (A), J7.4, K3.8 (T1)
unnamed: D12.1 (K), R20.1, R24.1
unnamed: D12.2 (A), J8.4, K4.8 (T1)
unnamed: J2.1 (VBUS), J9.1 (VBUS)
unnamed: J2.2 (D-), J9.2 (D-)
unnamed: J2.3 (D+), J9.3 (D+)
unnamed: J5.2, K2.9 (T2)
unnamed: J6.2, K1.9 (T2)
unnamed: J7.2, K3.9 (T2)
unnamed: J8.2, K4.9 (T2)
unnamed: Q1.1 (B), R1.2
unnamed: Q2.1 (B), R2.2
unnamed: Q3.1 (B), R3.2
unnamed: Q4.1 (B), R4.2
VCC: Beagle1.C5, Beagle1.C6, D1.1 (K), D2.1 (K), D3.1 (K), D4.1 (K), K1.1, K2.1, K3.1, K4.1

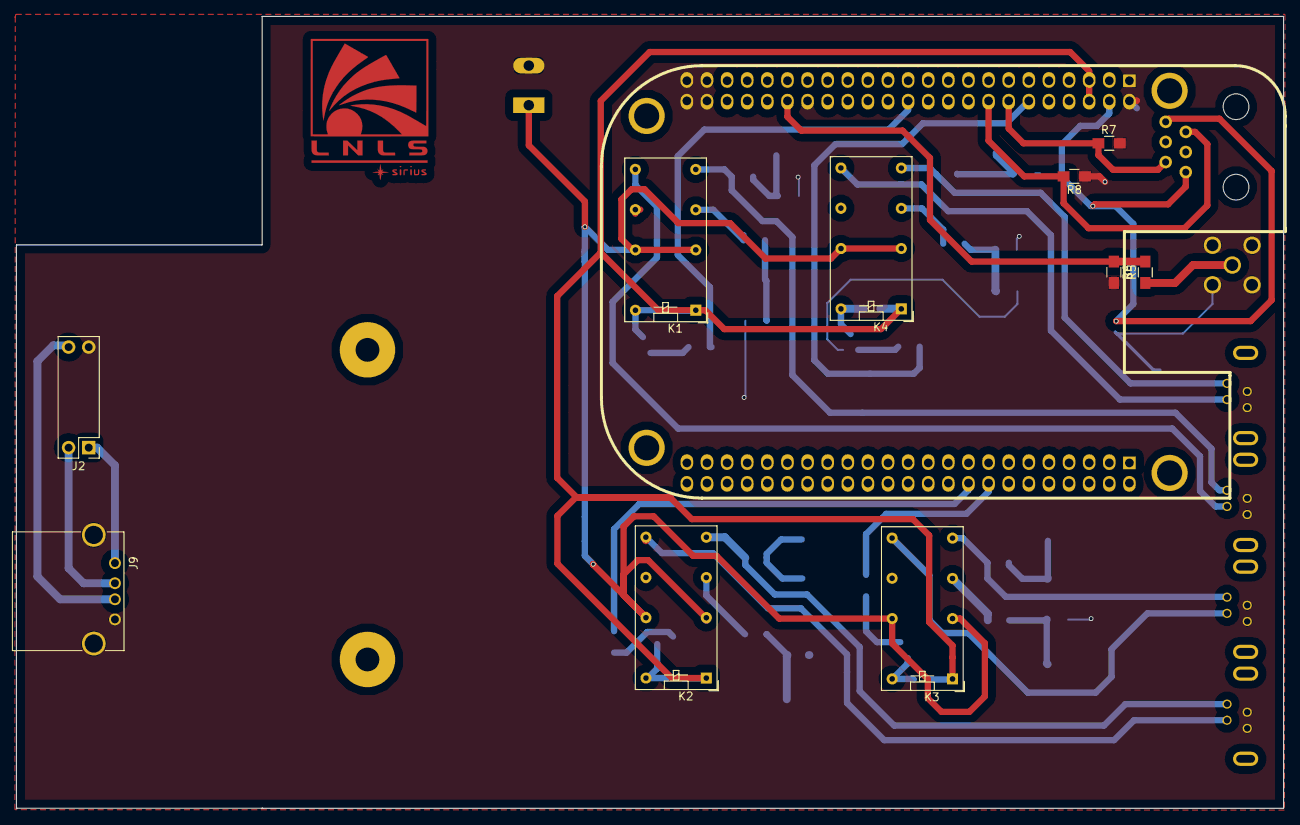
[picture p23: board VBC.kicad_pcb from above]

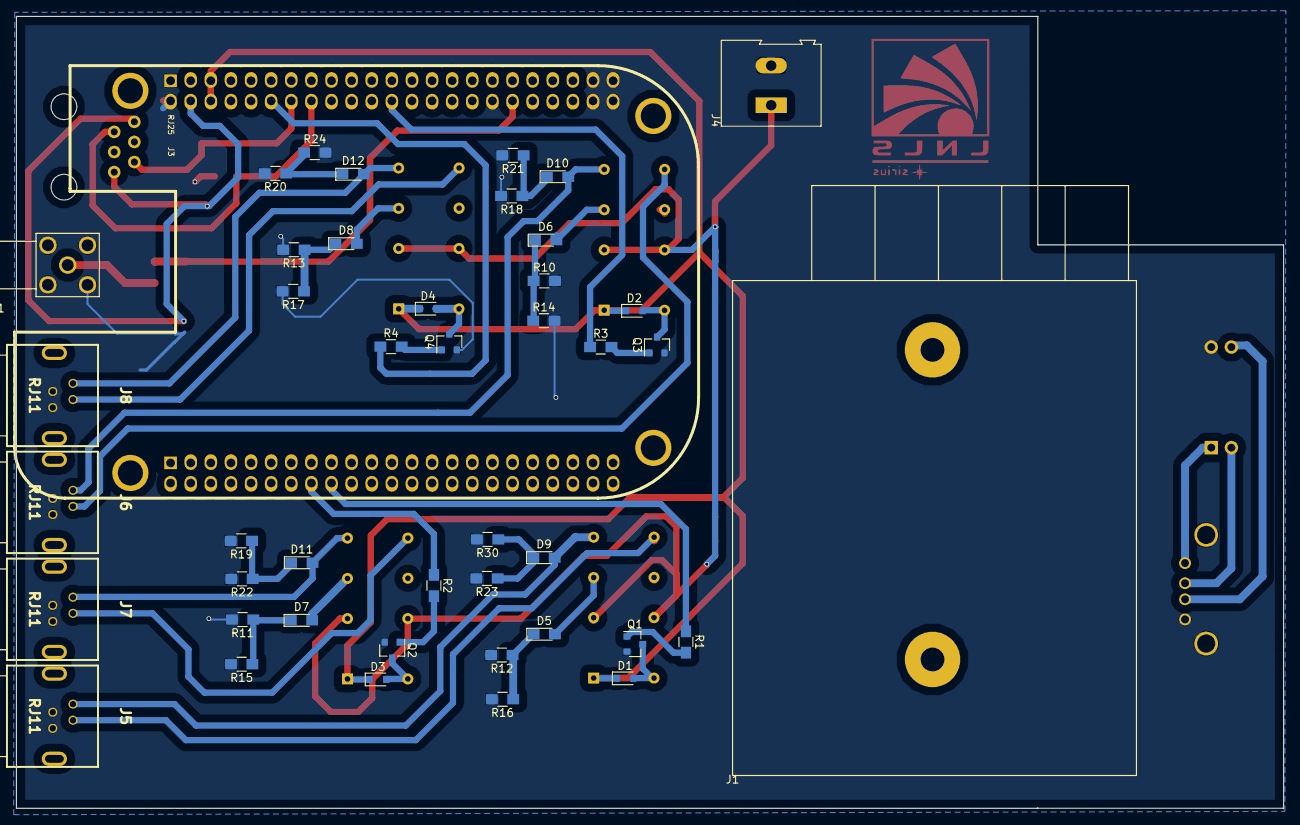
[picture p24: board VBC.kicad_pcb from below]

Board: 2 copper layers, 160.0 x 100.1 mm, 57 parts (45 on the bottom side), 43 nets.
