lnls-sirius/vacuum-bbb-controller/(commit log)

2018-06-14 updated hardware files
    [VBC.sch, _saved_VBC.sch]
2018-06-26 added TURBOVAC cable connection and updated ACP cable connection
    [ACP cable.kicad_pcb, ACP cable.sch, TURBOVAC cable.kicad_pcb, TURBOVAC cable.sch, VBC.kicad_pcb, VBC.sch, _saved_VBC.sch]
2018-06-26 repository reorganization
    [ACP cable.kicad_pcb, ACP cable.sch, TURBOVAC cable.kicad_pcb, TURBOVAC cable.sch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]
2018-07-02 added relay LED status in schematic
    [VBC.kicad_pcb, VBC.sch]
2018-07-02 new hardware version
    [VBC.kicad_pcb, VBC.sch]
2018-07-06 updated ACP and TURBOVAC libraries and unix socket for IOC
2018-07-10 added EPICS support for valves controls under unix socket
2018-07-11 added TURBOVAC support in unix socket for IOC
2018-07-12 minor changes in hardware files
    [VBC-B.Adhes.gbr, VBC-B.CrtYd.gbr, VBC-B.Cu.gbr, VBC-B.Fab.gbr, VBC-B.Mask.gbr, VBC-B.Paste.gbr, VBC-B.SilkS.gbr, VBC-Cmts.User.gbr]
2018-07-16 updated unix socket for IOC
2018-07-18 added support for analog reading (pressure)
2018-07-18 new hardware version - v2.0
    [USB_converter_485.sch, VBC.kicad_pcb, VBC.sch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]
2018-07-18 hardware version 1.0
    [VBC.kicad_pcb]
2018-07-18 updated hardware version 2.0
    [VBC_v2-0-B.Adhes.gbr, VBC_v2-0-B.CrtYd.gbr, VBC_v2-0-B.Cu.gbr, VBC_v2-0-B.Fab.gbr, VBC_v2-0-B.Mask.gbr, VBC_v2-0-B.Paste.gbr, VBC_v2-0-B.SilkS.gbr, VBC_v2-0-Cmts.User.gbr]
2018-07-18 added status PVs for process scripts; added thread support and split the code in two threads
2018-07-19 updated socket unix file
2018-07-19 updated process scripts and unix socket
2018-07-25 updated hardware version 2.1
    [USB_converter_485.sch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]
2018-07-27 adicionando paineis v2.1
    [Painel-frontal_VBC.dwg, Painel-frontal_VBC.dxf, Painel-frontal_VBC.kicad_pcb, Painel-frontal_VBC.sch, Painel-traseiro_VBC.dwg, Painel-traseiro_VBC.dxf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]
2018-07-31 parameterized PVs names and power of ten representation por pressure values added
2018-08-13 added cable file
    [cables.ods]
2018-08-17 updated cable file
    [cables.ods]
2018-08-20 added files about the power supply box
    [painel_v1-0.dwg, painel_v1-0.dxf, placa-fixacao.dwg]
2018-08-20 updated files about the power supply box
    [placa-fixacao.dwg, placa-fixacao_oficina.dwg, placa-fixacao_v2-0.dwg]
2018-08-23 repo reorganization & files updated
    [Painel-frontal_VBC.dwg, Painel-frontal_VBC.dxf, Painel-frontal_VBC.kicad_pcb, Painel-frontal_VBC.sch, Painel-traseiro_VBC.dwg, Painel-traseiro_VBC.dxf, painel_v1-0.dwg, painel_v1-0.dxf]
2018-09-14 fixed Windows/Linux incompatibilities for PyDM 1.2 release
    [TURBOVAC cable.sch]
2018-09-20 valve confirmation message width adjusted
2018-09-28 updated unix socket: write value 600 in parameter 28 at initialization (TURBOVAC)
2018-11-26 added VBC v2.2 files
    [USB_converter_485-2018-08-31-09-16-53.sch, USB_converter_485.sch, VBC_v2-1-2018-08-31-09-16-53.sch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]
2019-04-09 Agilent valve doc renamed
2019-04-10 Hammond enclosure datasheet added
2019-04-10 documentation pcb images added
2019-11-21 added confirmation message to venting valve operations
